1cooper/Three-axis-gimbal/README.md

# Three-axis gimbal

Status: In progress  
Sort: Prj

## TODO
- [x]  改进云台结构，4310电机承重2025-12-15 22:16:56
- [x]  等元器件，焊接2025-12-23 23:06:42
- [x]  改PCB sample LSB问题 dcdc啸叫2025-12-24 17:22:35
- [x]  等待PCB Ver1.12025-12-28 10:10:11
- [x]  焊接第二版
- [x]  开始打印结构件2026-01-03 15:18:30
- [x]  验证结构 2026-01-08 21:50:25
- [ ]  等Mech Ver1.2 2026-01-08 22:20:39

---

## Structure

### Ver1.0
<p align="center">
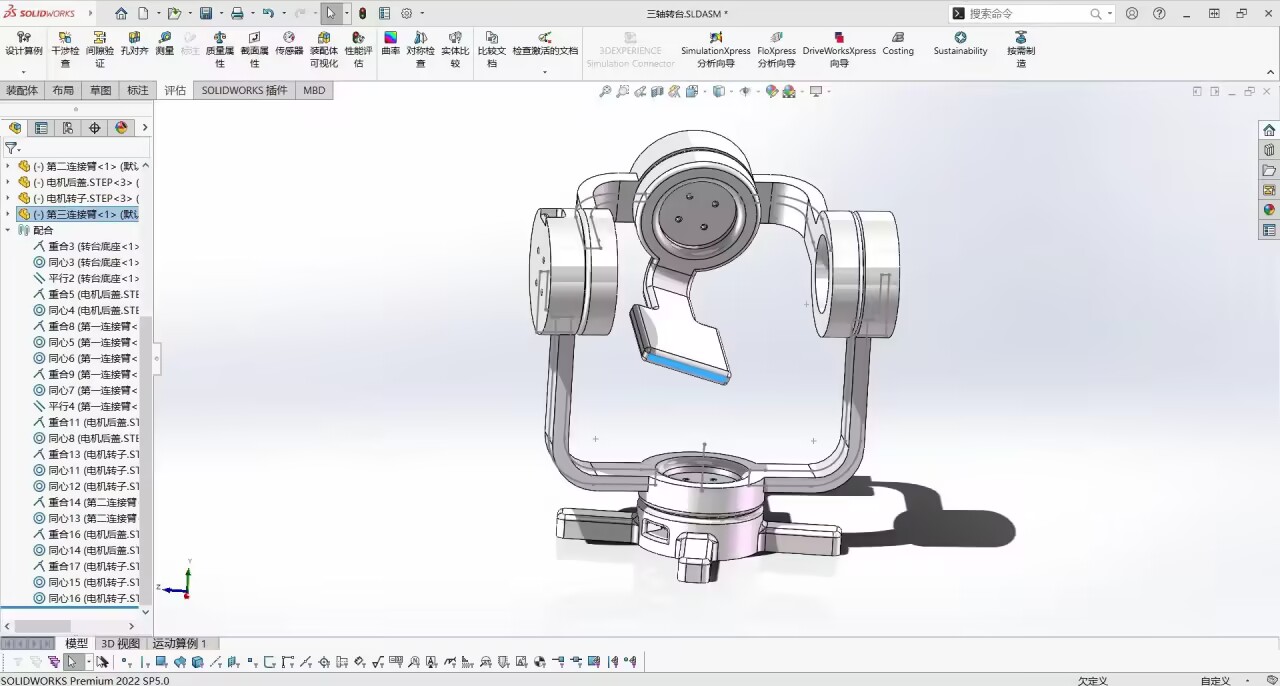
[picture p1: ExportBlock/9a7429444ead9815cb6c9cb01ef3c920_720.png]
  
</p>

### Ver1.1：底部加入支撑转盘
<p align="center">
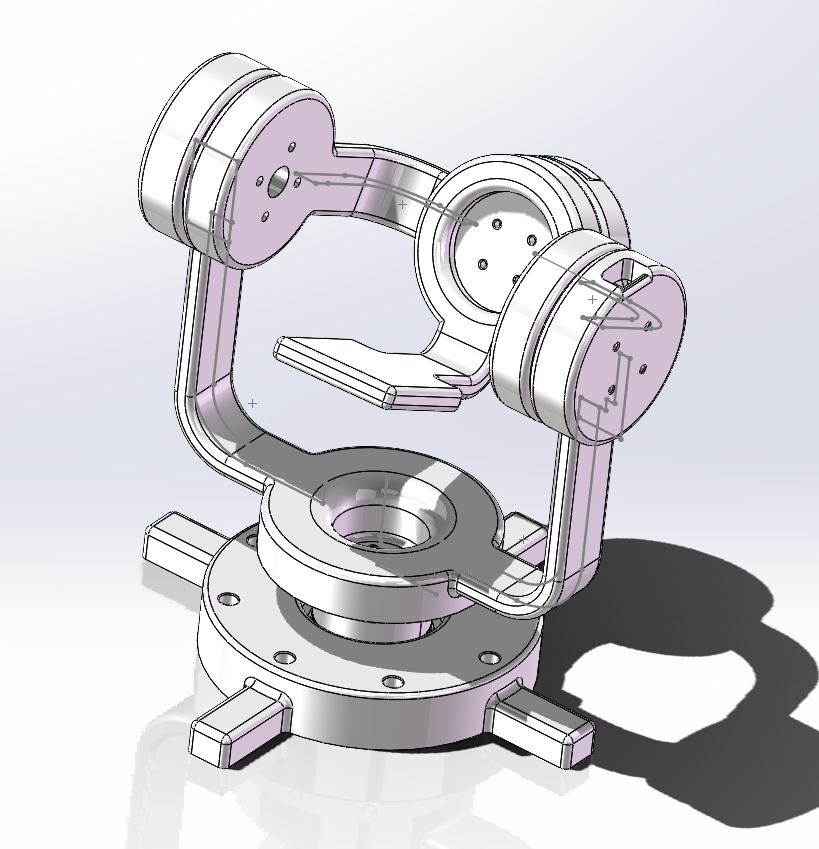
[picture p2: ExportBlock/image.png]
  
</p>

### Ver1.2：云台整体尺寸缩小
<p align="center">
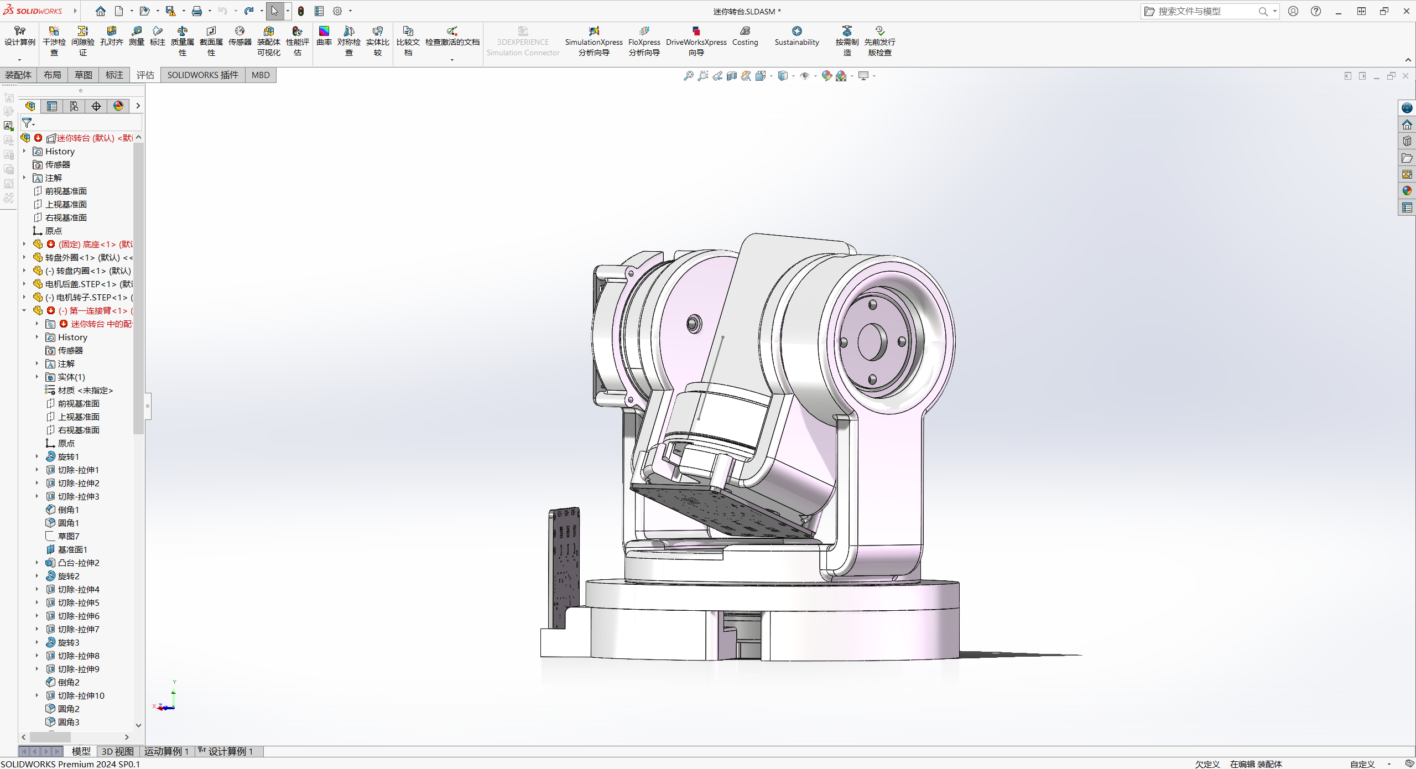
[picture p3: ExportBlock/image 1.png]
  
</p>

---

## Hardware

### Mini_Drv Ver1.0
<p align="center">
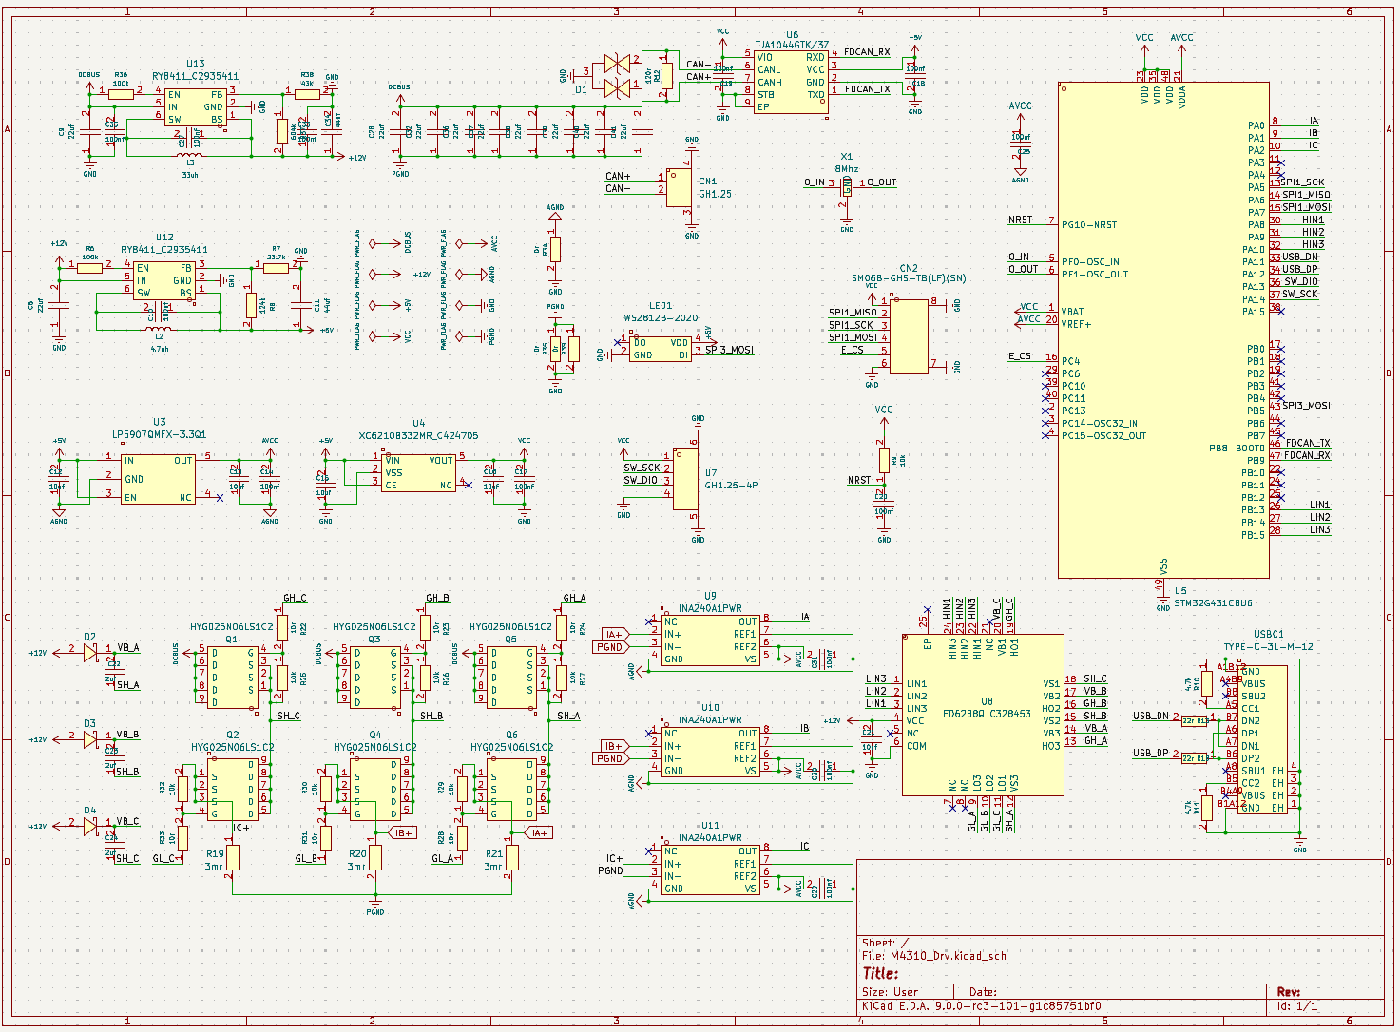
[picture p4: ExportBlock/image 2.png]
  <br>
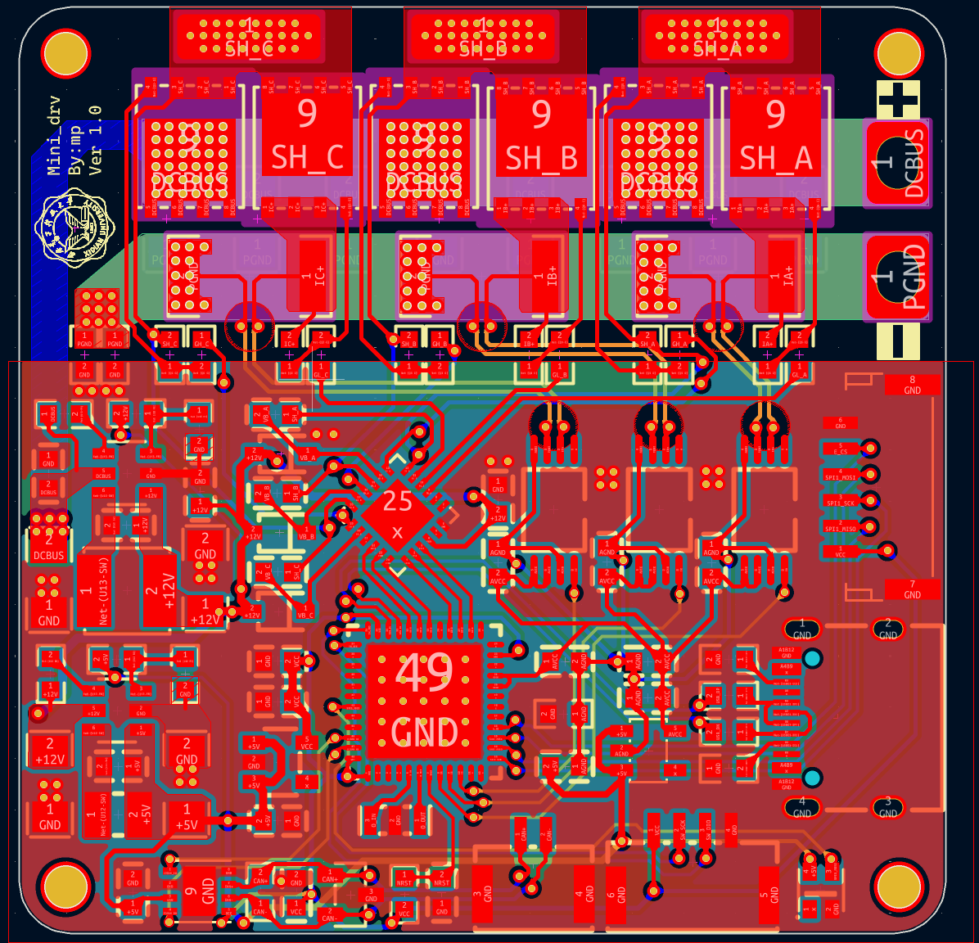
[picture p5: ExportBlock/image 3.png]
  <br>
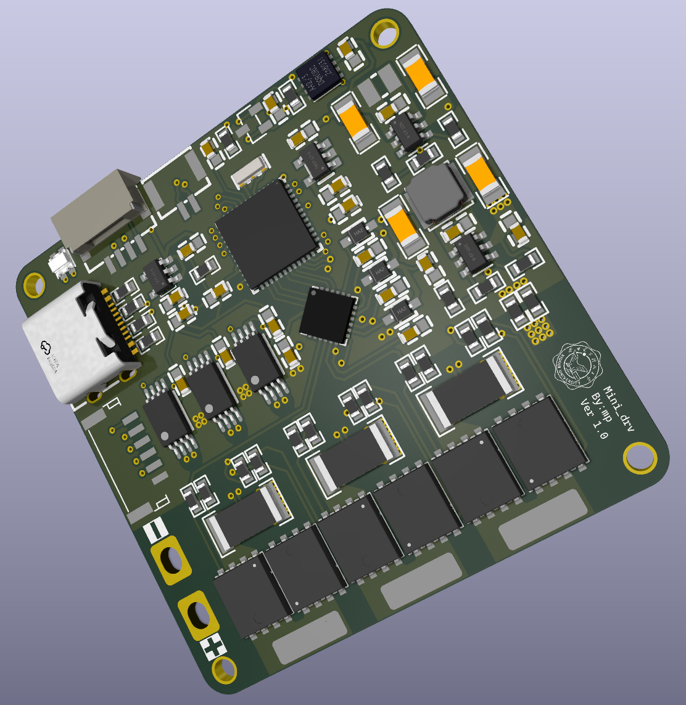
[picture p6: ExportBlock/image 4.png]
  
</p>

### Mini_Drv Ver1.1
<p align="center">
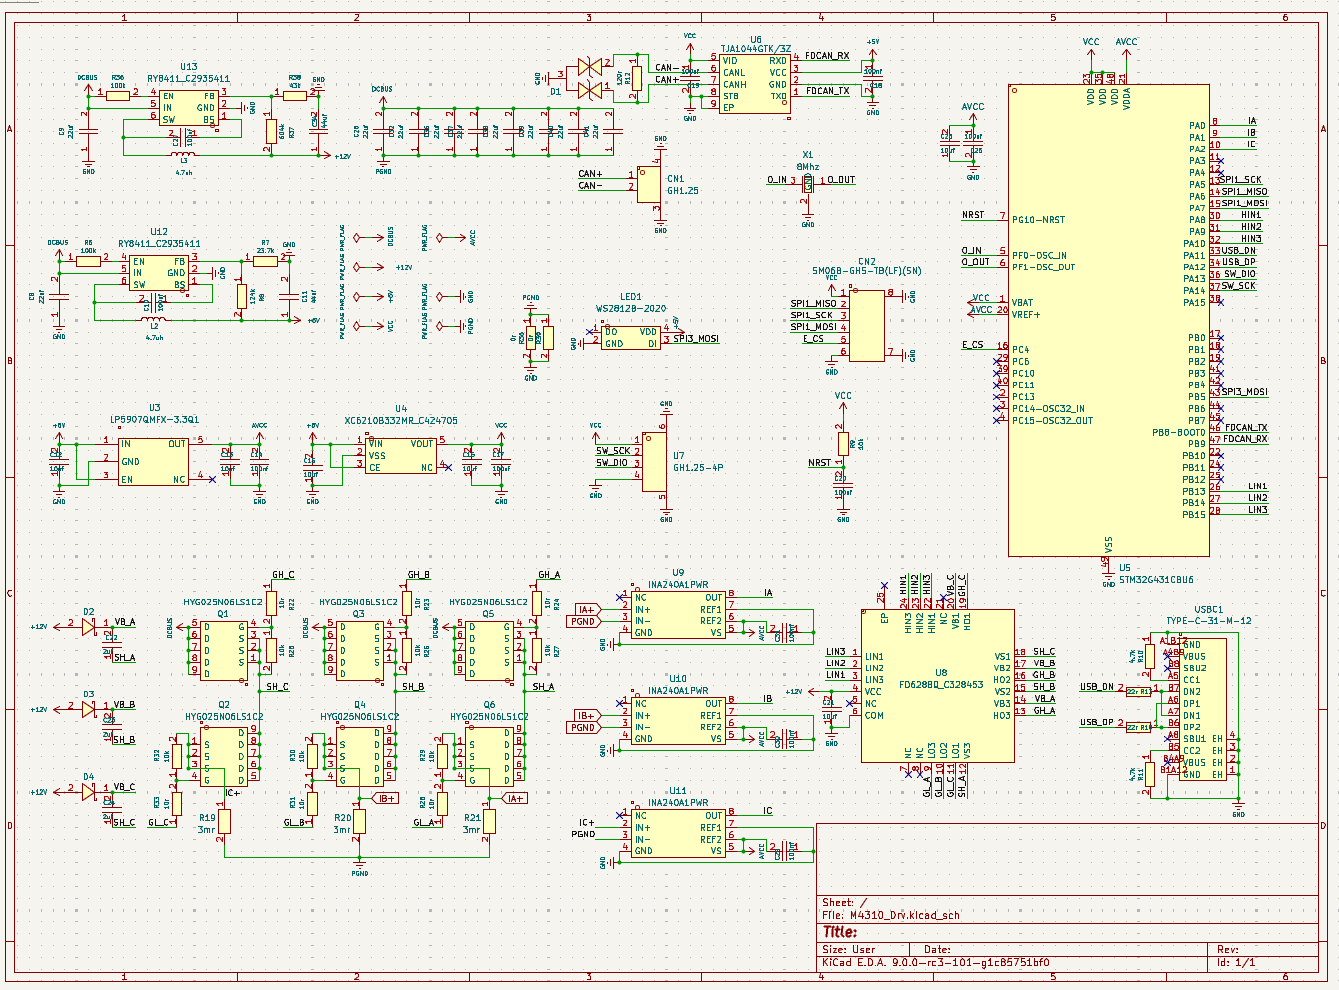
[picture p7: ExportBlock/image 5.png]
  <br>
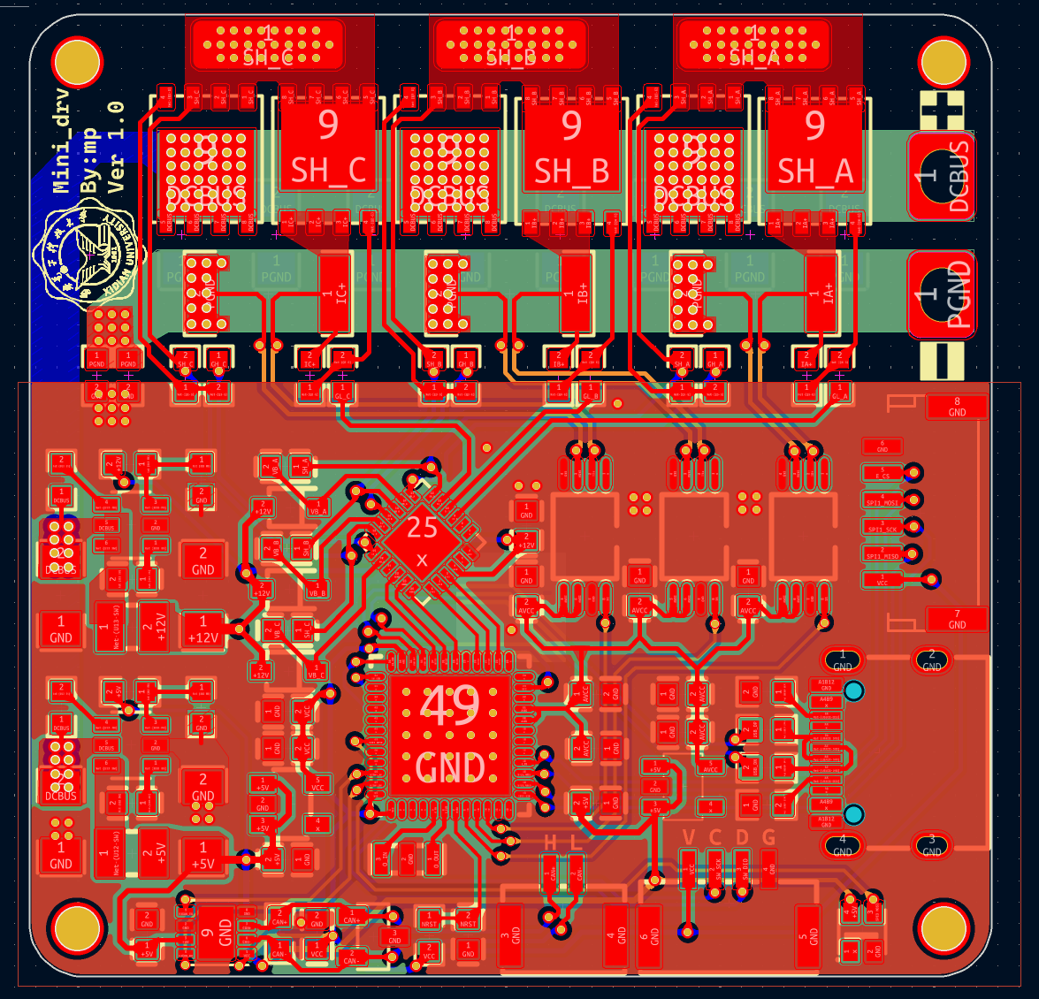
[picture p8: ExportBlock/image 6.png]
  <br>
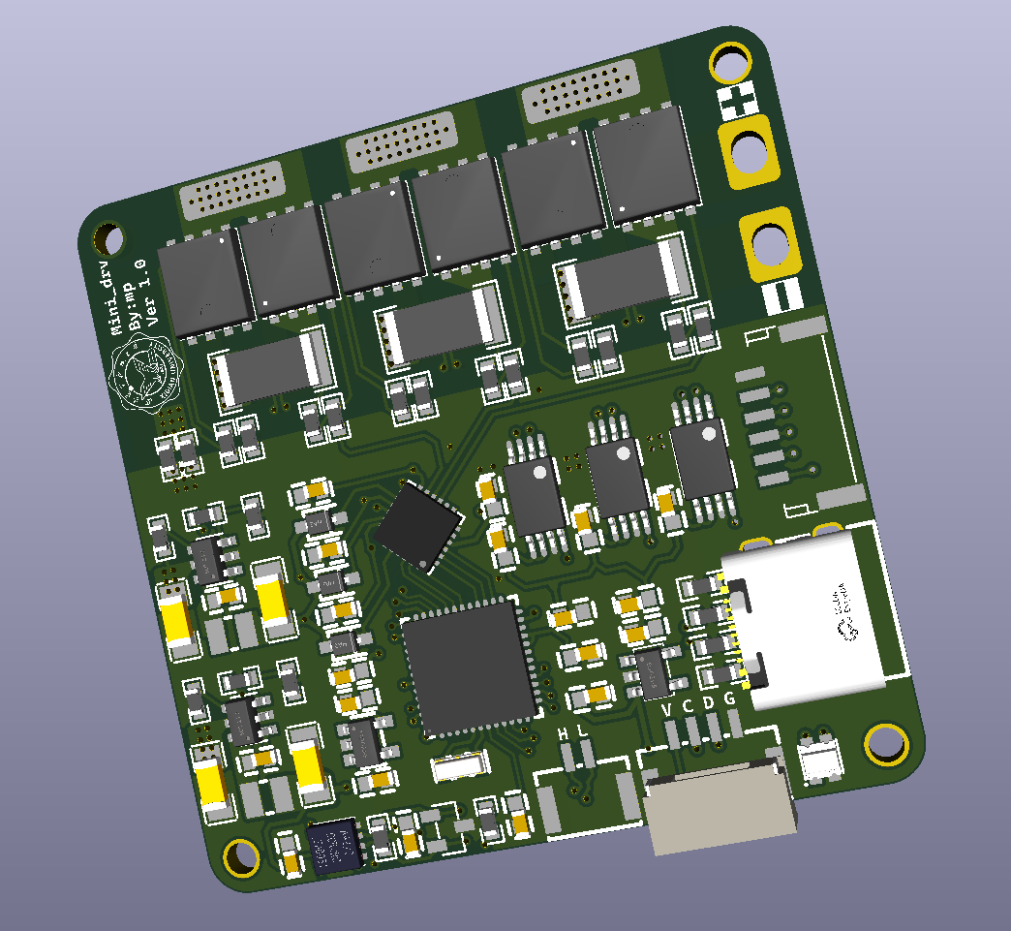
[picture p9: ExportBlock/image 7.png]
  
</p>

---

## Software

### pid参数
<p align="center">
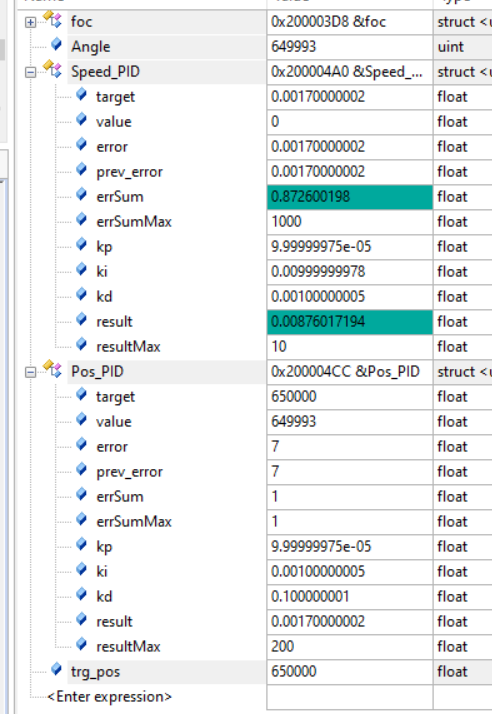
[picture p10: ExportBlock/image 8.png]
  
</p>

---

## Problems

### Hardware
- DCDC部分，错误地将芯片BS引脚与输出连在一起。
- MOS啸叫，未找到原因。纠正：MOS不会啸叫，压电类器件更易啸叫。

<p align="center">
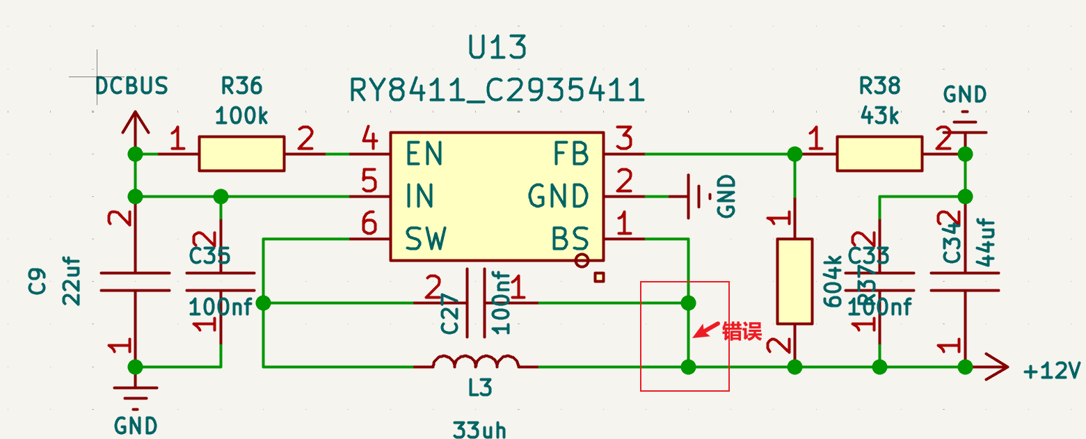
[picture p11: ExportBlock/Snipaste_2025-12-21_15-04-18.png]
  
</p>

### Mech
- 主体太大——下一版V1.2，建议10x10x10cm。
- PCB固定座偏小，不能完全嵌入，需留余量，可以竖直摆放。

<p align="center">
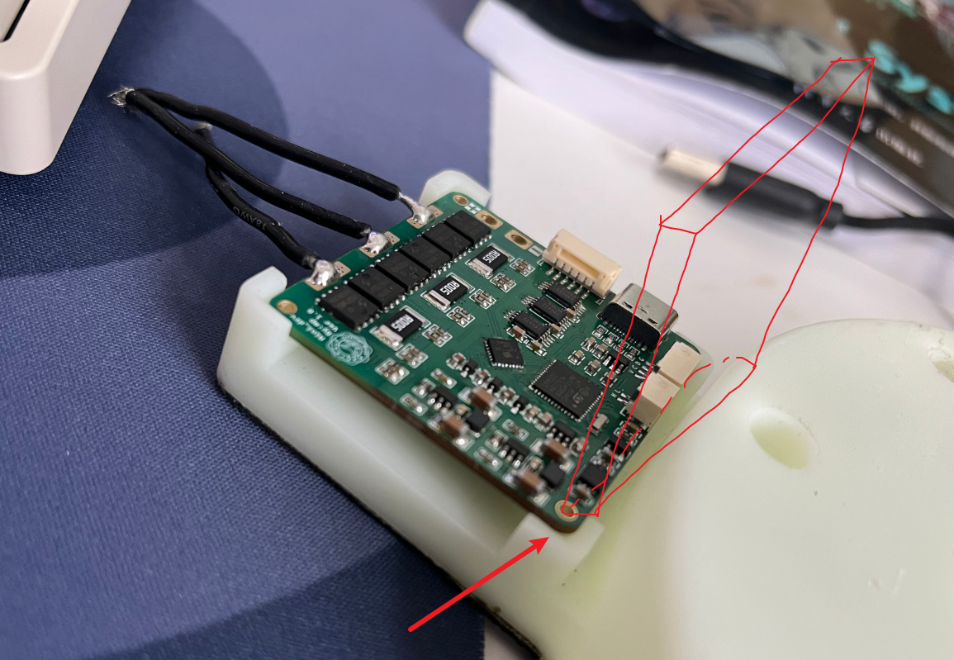
[picture p12: ExportBlock/image 9.png]
  
</p>
