1cooper/Three-axis-gimbal/Mech/三轴转台-双支撑/三轴转台.SLDASM

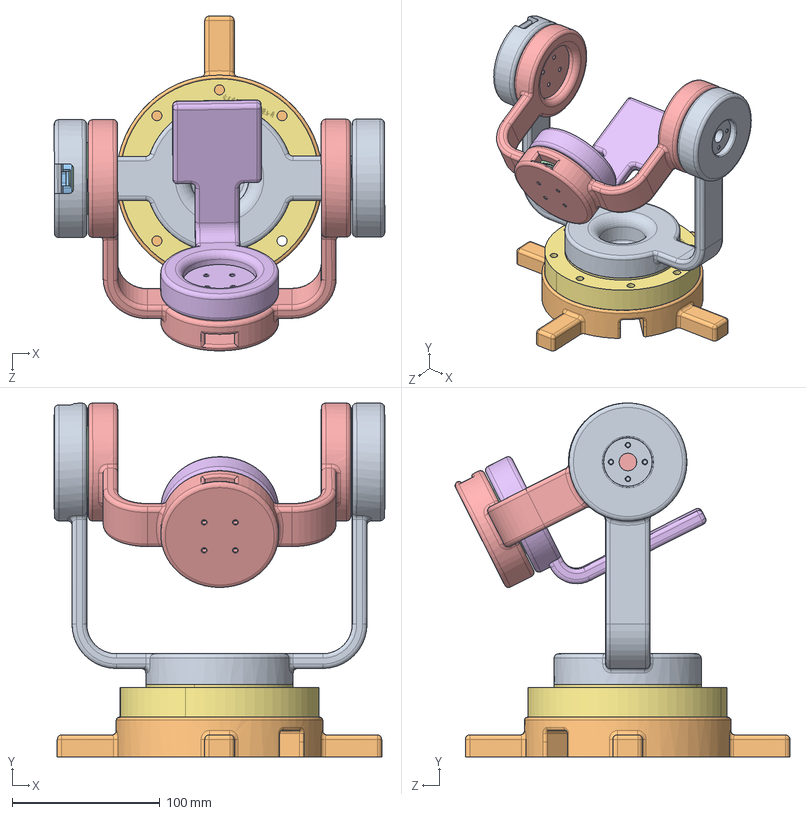
[picture p13: CAD file, 2026-01-08]
Mech/三轴转台-双支撑/三轴转台.SLDASM
224.1 x 240.0 x 227.0 mm
第一连接臂
转台底座
电机后盖.STEP x 3
电机转子.STEP x 3
第二连接臂
第三连接臂
3264716736010.10.100(1).step
