1cooper/Three-axis-gimbal/Hardware/M4310_Drv/edgecut.DXF

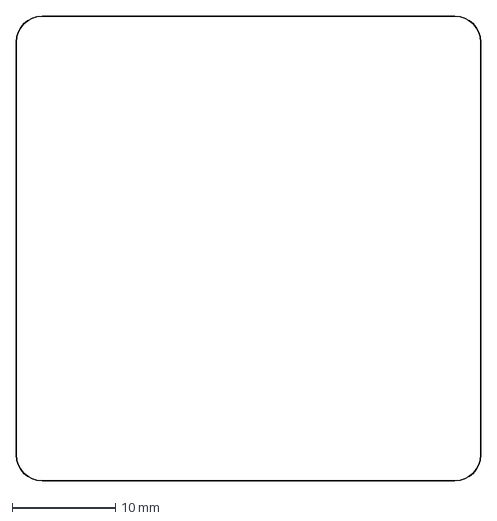
[picture p14: CAD file, 2025-12-28]
Hardware/M4310_Drv/edgecut.DXF
45.0 x 45.0 mm
