1cooper/Three-axis-gimbal/Mech/三轴转台-双支撑/第三连接臂.SLDPRT

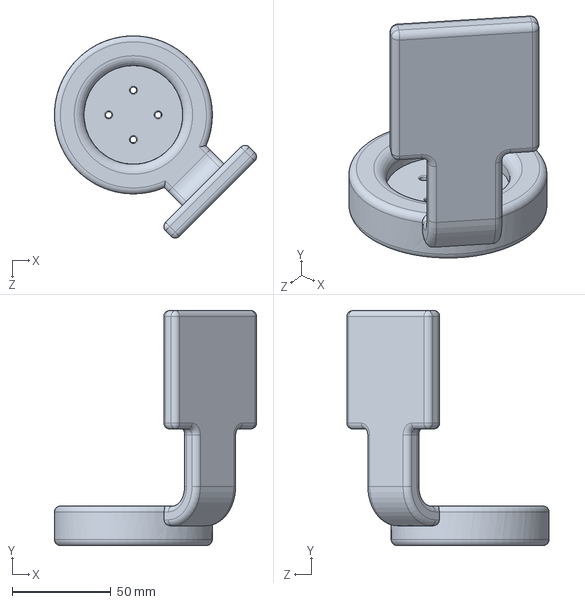
[picture p15: CAD file, 2026-01-08]
Mech/三轴转台-双支撑/第三连接臂.SLDPRT
102.4 x 119.0 x 102.4 mm
