1cooper/Three-axis-gimbal/Mech/板框中心线.DXF

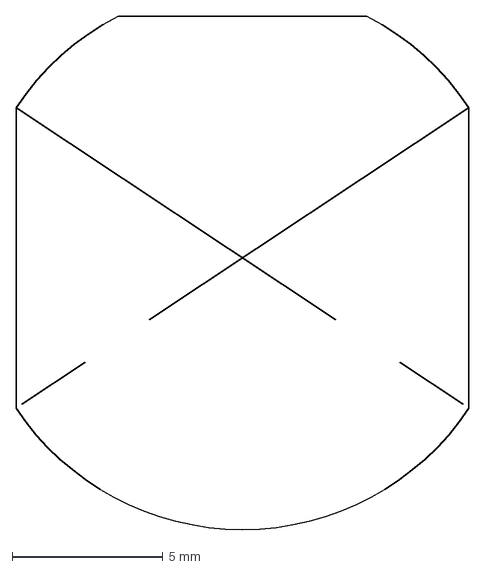
[picture p16: CAD file, 2025-12-28]
Mech/板框中心线.DXF
15.0 x 17.0 mm
