1cooper/Three-axis-gimbal/Mech/三轴转台-双支撑/第一连接臂.SLDPRT

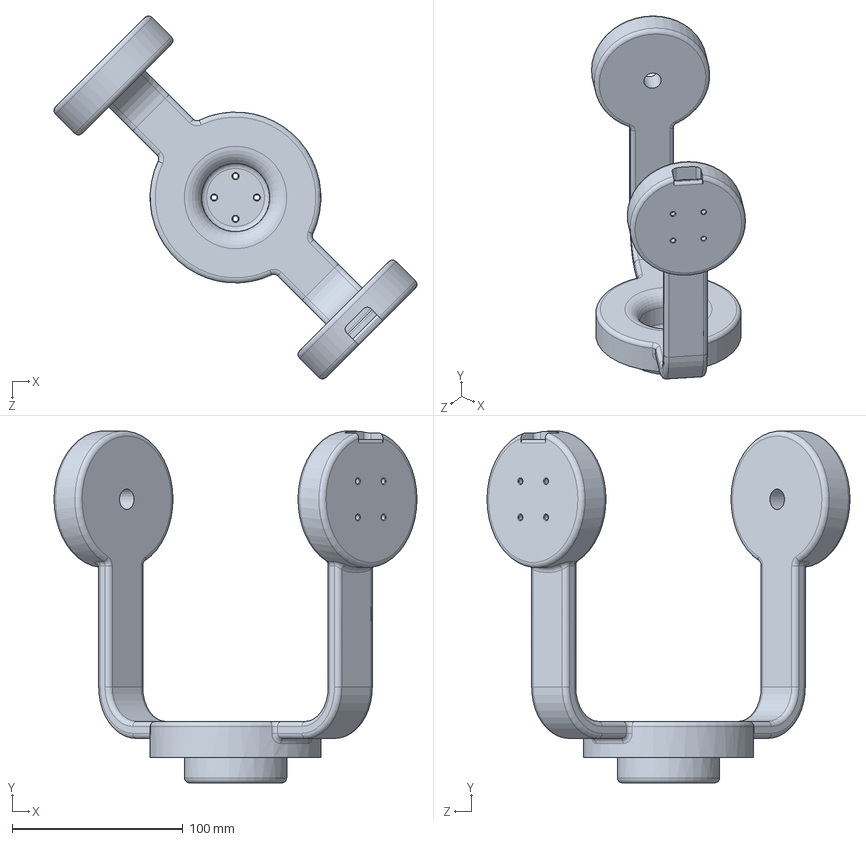
[picture p17: CAD file, 2026-01-08]
Mech/三轴转台-双支撑/第一连接臂.SLDPRT
212.5 x 205.9 x 212.5 mm
