1cooper/Three-axis-gimbal/Mech/三轴转台-双支撑/转台底座.SLDPRT

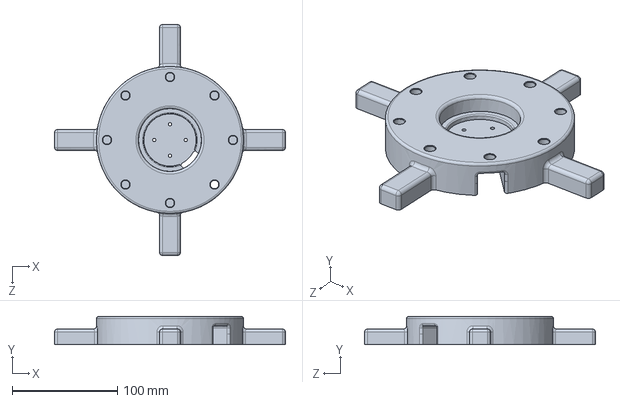
[picture p18: CAD file, 2026-01-08]
Mech/三轴转台-双支撑/转台底座.SLDPRT
220.0 x 27.0 x 220.0 mm
