1cooper/Three-axis-gimbal/Mech/三轴转台-双支撑/电机后盖.STEP.SLDPRT

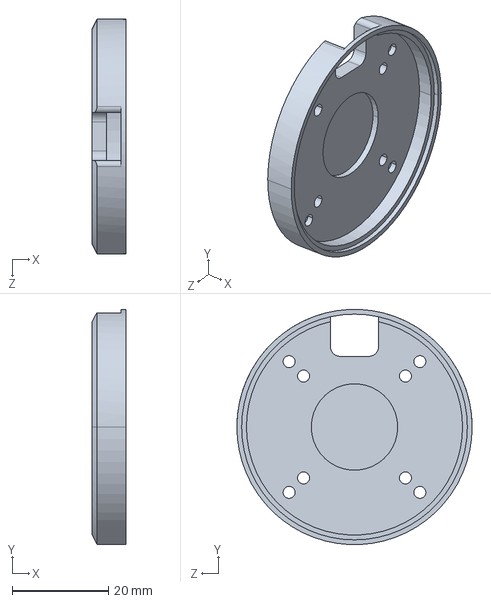
[picture p19: CAD file, 2026-01-08]
Mech/三轴转台-双支撑/电机后盖.STEP.SLDPRT
7.00 x 48.9 x 49.0 mm
