1cooper/Three-axis-gimbal/Mech/三轴转台-双支撑/第二连接臂.SLDPRT

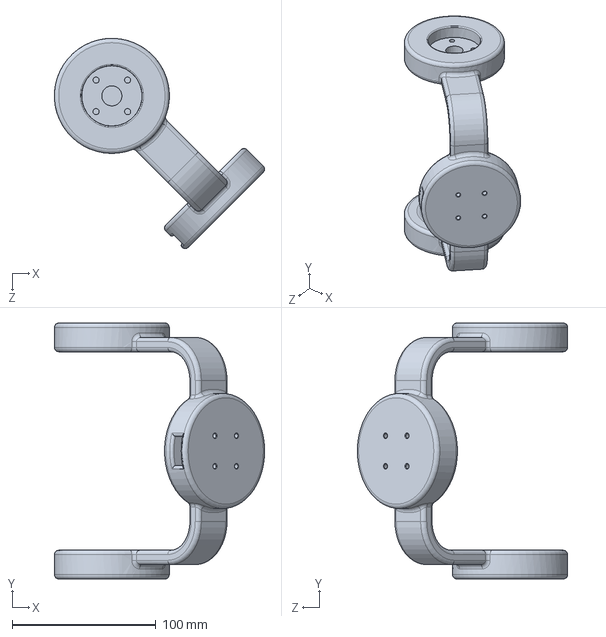
[picture p20: CAD file, 2026-01-08]
Mech/三轴转台-双支撑/第二连接臂.SLDPRT
146.2 x 178.0 x 146.2 mm
