1cooper/Three-axis-gimbal/Mech/三轴转台-双支撑/电机转子.STEP.SLDPRT

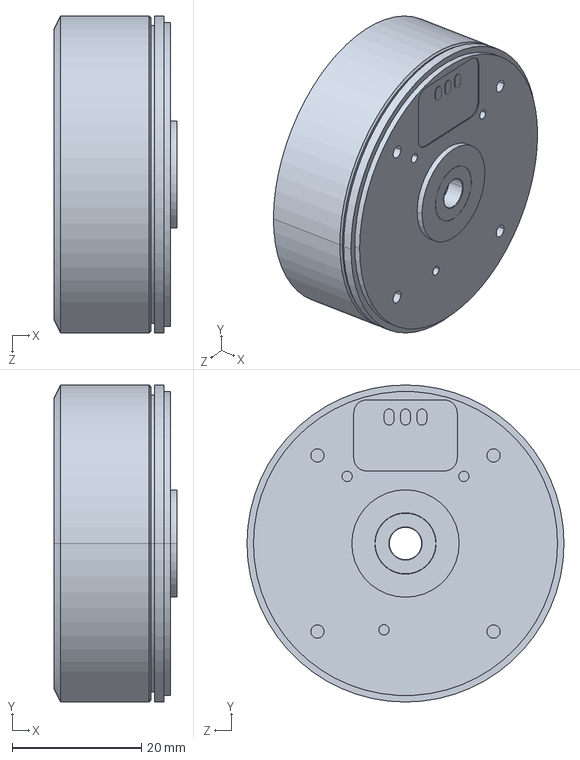
[picture p21: CAD file, 2026-01-08]
Mech/三轴转台-双支撑/电机转子.STEP.SLDPRT
19.0 x 49.0 x 49.0 mm
