1cooper/Three-axis-gimbal/Mech/三轴转台-双支撑/3264716736010.10.100(1).STEP

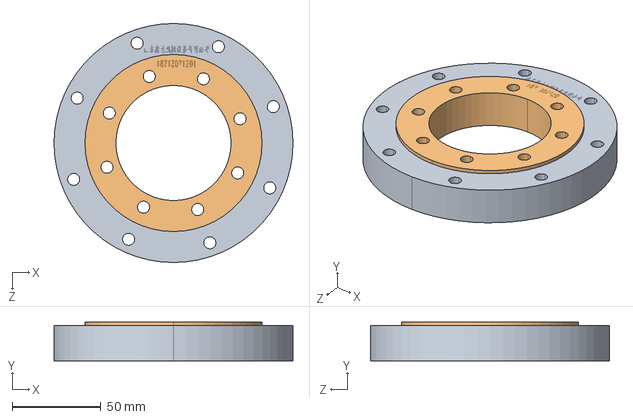
[picture p22: CAD file, 2026-01-08]
Mech/三轴转台-双支撑/3264716736010.10.100(1).STEP
135.0 x 22.0 x 135.0 mm
