1cooper/Three-axis-gimbal/(list of files, cad)

Other CAD files:
Mech/板框.SLDPRT
Mech/板框.DXF
