1cooper/Three-axis-gimbal/Hardware/M4310_Drv/M4310_Drv.kicad_sch

## KiCad design Hardware/M4310_Drv/M4310_Drv.kicad_sch (2025-12-28)

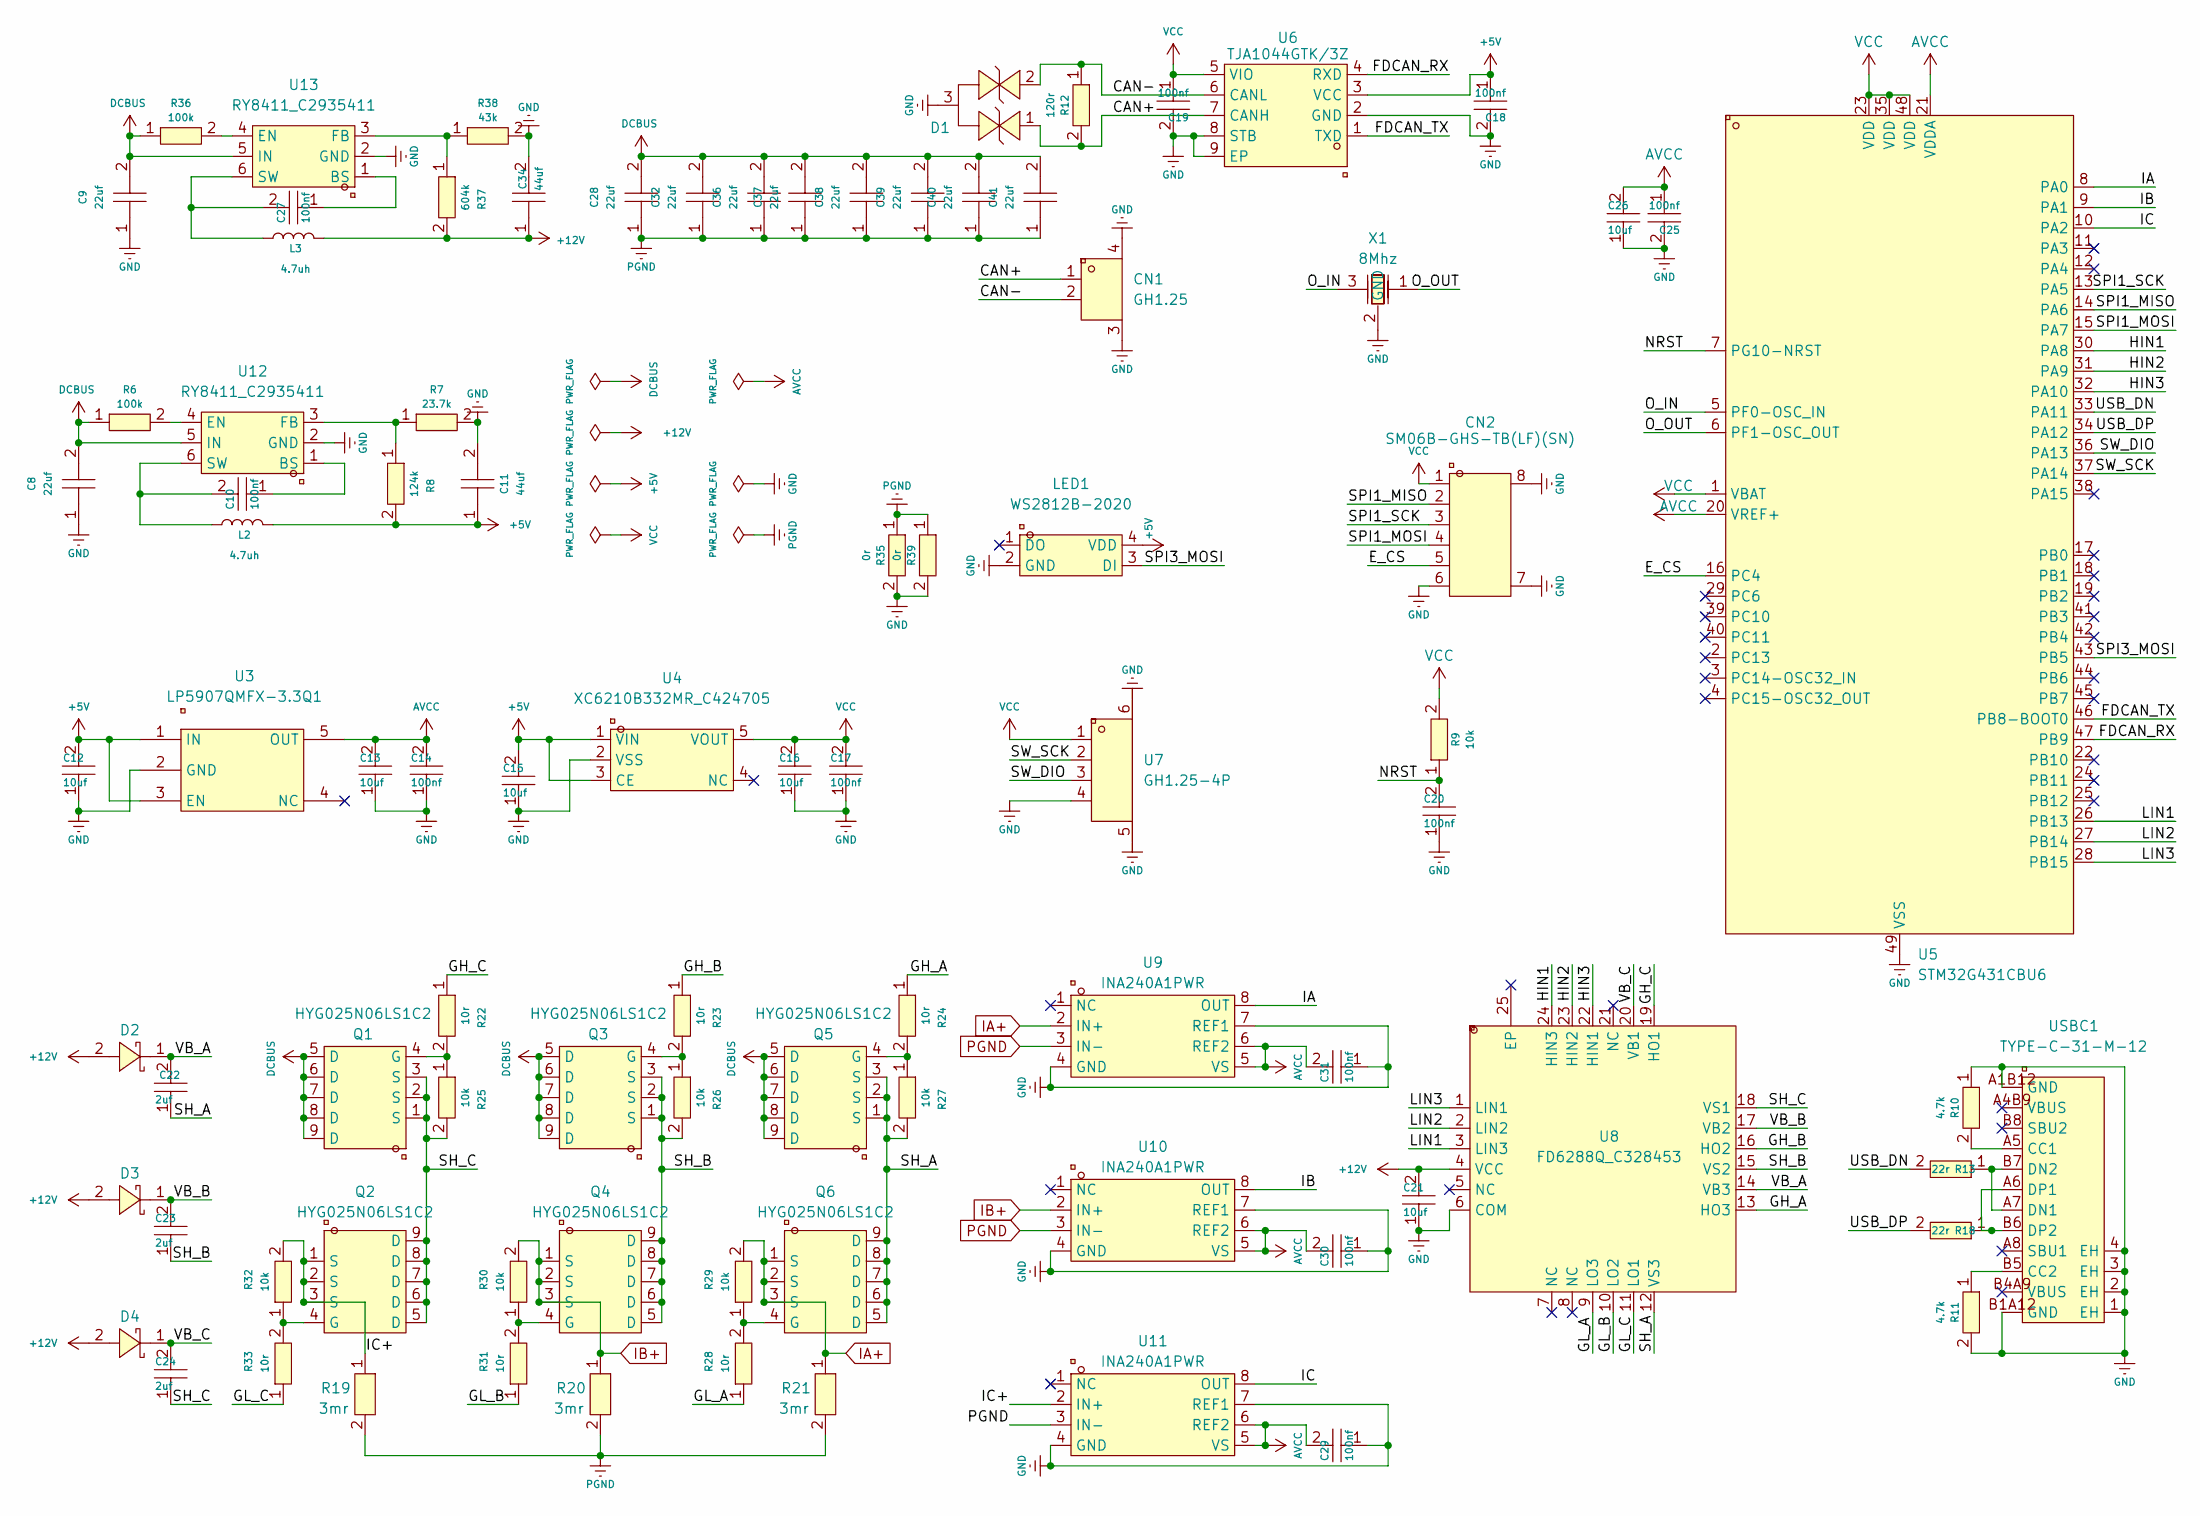
[picture p23: schematic M4310_Drv.kicad_sch]

Parts:
C8, C9, C28, C32, C36, C37, C38, C39, C40, C41: 22uf; C1206; LCSC Part C89632
C10, C14, C17, C18, C19, C20, C25, C27, C29, C30, C31: 100nf; C0603; LCSC Part C1604
C11, C34: 44uf; C1206; LCSC Part C89632
C12, C13, C15, C16, C21, C26: 10uf; C0603; LCSC Part C1604
C22, C23, C24: 2uf; C0603; LCSC Part C1604
CN1: GH1.25; CONN-TH_2P-P1.25_XUNPU_WAFER-GH1.25-2PWB; LCSC Part C3029377
CN2: SM06B-GHS-TB(LF)(SN); CONN-TH_SM06B-GHS-TB-LF-SN; LCSC Part C133065
D1: NUP2105LT1G_C2890118; SOT-23-3_L2.9-W1.3-P1.90-LS2.4-BR; LCSC Part C2890118
D2, D3, D4: 1N5819WS S4; SOD-323_L1.6-W1.3-LS2.7-RD; LCSC Part C2927280
L2, L3: 4.7uh; IND-SMD_L2.5-W2.0
LED1: WS2812B-2020; LED-SMD_4P-L2.0-W2.0-TL_WS2812B-2020; LCSC Part C965555
Q1, Q2, Q3, Q4, Q5, Q6: HYG025N06LS1C2; DFN-8_L5.9-W5.2-P1.27-LS6.2-BL; LCSC Part C2827231
R6, R36: 100k; R0603; LCSC Part C14675
R7: 23.7k; R0603; LCSC Part C14675
R8: 124k; R0603; LCSC Part C14675
R9, R25, R26, R27, R29, R30, R32: 10k; R0603; LCSC Part C14675
R10, R11: 4.7k; R0603; LCSC Part C14675
R12: 120r; R0603; LCSC Part C14675
R13, R18: 22r; R0603; LCSC Part C14675
R19, R20, R21: 3mr; R2512; LCSC Part C46634460
R22, R23, R24, R28, R31, R33: 10r; R0603; LCSC Part C14675
R35, R39: 0r; R0603; LCSC Part C14675
R37: 604k; R0603; LCSC Part C14675
R38: 43k; R0603; LCSC Part C14675
U3: LP5907QMFX-3.3Q1; SOT-23-5_L3.0-W1.7-P0.95-LS2.8-BR; LCSC Part C130005
U4: XC6210B332MR_C424705; TSOT-23-5_L2.9-W1.6-P0.95-LS2.8-BR; LCSC Part C424705
U5: STM32G431CBU6; VQFN-48_L7.0-W7.0-P0.50-BL-EP5.5; LCSC Part C529356
U6: TJA1044GTK/3Z; HVSON-8_L3.0-W3.0-P0.65-BL-EP; LCSC Part C2157795
U7: GH1.25-4P; CONN-SMD_4P-P1.25_XUNPU_WAFER-GH1.25-4PWB; LCSC Part C3029379
U8: FD6288Q_C328453; QFN-24_L4.0-W4.0-P0.50-BL-EP2.6; LCSC Part C328453
U9, U10, U11: INA240A1PWR; TSSOP-8_L4.4-W3.0-P0.65-LS6.4-BL; LCSC Part C93965
U12, U13: RY8411_C2935411; SOT-23-6_L2.9-W1.6-P0.95-LS2.8-TL; LCSC Part C2935411
USBC1: TYPE-C-31-M-12; USB-C_SMD-TYPE-C-31-M-12_1; LCSC Part C165948
X1: 8Mhz; OSC-SMD_3P-L3.2-W1.3-P1.20-L; LCSC Part C341525

Connections:
+5V: C11.1, C12.2, C15.2, C18.1, L2.2, LED1.4 (VDD), R8.2, U3.1 (IN), U3.3 (EN), U4.1 (VIN), U4.3 (CE), U6.3 (VCC)
+12V: C21.2, C34.1, D2.2, D3.2, D4.2, L3.2, R37.2, U8.4 (VCC)
AVCC: C13.2, C14.2, C25.1, C26.2, C29.2, C30.2, C31.2, U3.5 (OUT), U5.20 (VREF+), U5.21 (VDDA), U9.5 (VS), U9.6 (REF2), U10.5 (VS), U10.6 (REF2), U11.5 (VS), U11.6 (REF2)
CAN+: CN1.1, D1.1, R12.2, U6.7 (CANH)
CAN-: CN1.2, D1.2, R12.1, U6.6 (CANL)
DCBUS: C8.2, C9.2, C28.2, C32.2, C36.2, C37.2, C38.2, C39.2, C40.2, C41.2, Q1.5 (D), Q1.6 (D), Q1.7 (D), Q1.8 (D), Q1.9 (D), Q3.5 (D), Q3.6 (D), Q3.7 (D), Q3.8 (D), Q3.9 (D), Q5.5 (D), Q5.6 (D), Q5.7 (D), Q5.8 (D), Q5.9 (D), R6.1, R36.1, U12.5 (IN), U13.5 (IN)
E_CS: CN2.5, U5.16 (PC4)
FDCAN_RX: U5.47 (PB9), U6.4 (RXD)
FDCAN_TX: U5.46 (PB8-BOOT0), U6.1 (TXD)
GH_A: R24.1, U8.13 (HO3)
GH_B: R23.1, U8.16 (HO2)
GH_C: R22.1, U8.19 (HO1)
GL_A: R28.1, U8.9 (LO3)
GL_B: R31.1, U8.10 (LO2)
GL_C: R33.1, U8.11 (LO1)
GND: C8.1, C9.1, C11.2, C12.1, C13.1, C14.1, C15.1, C16.1, C17.1, C18.2, C19.2, C20.1, C21.1, C25.2, C26.1, C29.1, C30.1, C31.1, C34.2, CN1.3, CN1.4, CN2.6, CN2.7, CN2.8, D1.3, LED1.2 (GND), R7.2, R10.1, R11.2, R35.2, R38.2, R39.2, U3.2 (GND), U4.2 (VSS), U5.49 (VSS), U6.2 (GND), U6.8 (STB), U6.9 (EP), U7.4, U7.5, U7.6, U8.6 (COM), U9.4 (GND), U9.7 (REF1), U10.4 (GND), U10.7 (REF1), U11.4 (GND), U11.7 (REF1), U12.2 (GND), U13.2 (GND), USBC1.1 (EH), USBC1.2 (EH), USBC1.3 (EH), USBC1.4 (EH), USBC1.A1B12 (GND), USBC1.B1A12 (GND), X1.2 (GND)
HIN1: U5.30 (PA8), U8.24 (HIN3)
HIN2: U5.31 (PA9), U8.23 (HIN2)
HIN3: U5.32 (PA10), U8.22 (HIN1)
IA: U5.8 (PA0), U9.8 (OUT)
IA+: Q6.1 (S), Q6.2 (S), Q6.3 (S), R21.1, R29.2, U9.2 (IN+)
IB: U5.9 (PA1), U10.8 (OUT)
IB+: Q4.1 (S), Q4.2 (S), Q4.3 (S), R20.1, R30.2, U10.2 (IN+)
IC: U5.10 (PA2), U11.8 (OUT)
IC+: Q2.1 (S), Q2.2 (S), Q2.3 (S), R19.1, R32.2, U11.2 (IN+)
LIN1: U5.26 (PB13), U8.3 (LIN3)
LIN2: U5.27 (PB14), U8.2 (LIN2)
LIN3: U5.28 (PB15), U8.1 (LIN1)
NRST: C20.2, R9.1, U5.7 (PG10-NRST)
unnamed: C10.1, U12.1 (BS)
unnamed: C10.2, L2.1, U12.6 (SW)
unnamed: C27.1, U13.1 (BS)
unnamed: C27.2, L3.1, U13.6 (SW)
unnamed: Q1.4 (G), R22.2, R25.1
unnamed: Q2.4 (G), R32.1, R33.2
unnamed: Q3.4 (G), R23.2, R26.1
unnamed: Q4.4 (G), R30.1, R31.2
unnamed: Q5.4 (G), R24.2, R27.1
unnamed: Q6.4 (G), R28.2, R29.1
unnamed: R6.2, U12.4 (EN)
unnamed: R7.1, R8.1, U12.3 (FB)
unnamed: R10.2, USBC1.A5 (CC1)
unnamed: R11.1, USBC1.B5 (CC2)
unnamed: R13.1, USBC1.A7 (DN1), USBC1.B7 (DN2)
unnamed: R18.1, USBC1.A6 (DP1), USBC1.B6 (DP2)
unnamed: R36.2, U13.4 (EN)
unnamed: R37.1, R38.1, U13.3 (FB)
O_IN: U5.5 (PF0-OSC_IN), X1.3
O_OUT: U5.6 (PF1-OSC_OUT), X1.1
PGND: C28.1, C32.1, C36.1, C37.1, C38.1, C39.1, C40.1, C41.1, R19.2, R20.2, R21.2, R35.1, R39.1, U9.3 (IN-), U10.3 (IN-), U11.3 (IN-)
SH_A: C22.1, Q5.1 (S), Q5.2 (S), Q5.3 (S), Q6.5 (D), Q6.6 (D), Q6.7 (D), Q6.8 (D), Q6.9 (D), R27.2, U8.12 (VS3)
SH_B: C23.1, Q3.1 (S), Q3.2 (S), Q3.3 (S), Q4.5 (D), Q4.6 (D), Q4.7 (D), Q4.8 (D), Q4.9 (D), R26.2, U8.15 (VS2)
SH_C: C24.1, Q1.1 (S), Q1.2 (S), Q1.3 (S), Q2.5 (D), Q2.6 (D), Q2.7 (D), Q2.8 (D), Q2.9 (D), R25.2, U8.18 (VS1)
SPI1_MISO: CN2.2, U5.14 (PA6)
SPI1_MOSI: CN2.4, U5.15 (PA7)
SPI1_SCK: CN2.3, U5.13 (PA5)
SPI3_MOSI: LED1.3 (DI), U5.43 (PB5)
SW_DIO: U5.36 (PA13), U7.3
SW_SCK: U5.37 (PA14), U7.2
USB_DN: R13.2, U5.33 (PA11)
USB_DP: R18.2, U5.34 (PA12)
VB_A: C22.2, D2.1, U8.14 (VB3)
VB_B: C23.2, D3.1, U8.17 (VB2)
VB_C: C24.2, D4.1, U8.20 (VB1)
VCC: C16.2, C17.2, C19.1, CN2.1, R9.2, U4.5 (VOUT), U5.1 (VBAT), U5.23 (VDD), U5.35 (VDD), U5.48 (VDD), U6.5 (VIO), U7.1
