1cooper/Three-axis-gimbal/Software/Mini_Drv/Mini_Drv.ioc

Mcu.UserName=STM32G431CBUx
PA0.Signal=ADC1_IN1
PA1.Signal=ADC1_IN2
PA10.Signal=S_TIM1_CH3
PA11.Signal=USB_DM
PA12.Signal=USB_DP
PA13.Signal=SYS_JTMS-SWDIO
PA14.Signal=SYS_JTCK-SWCLK
PA2.Signal=ADC1_IN3
PA5.Signal=SPI1_SCK
PA6.Signal=SPI1_MISO
PA7.Signal=SPI1_MOSI
PA8.Signal=S_TIM1_CH1
PA9.Signal=S_TIM1_CH2
PB13.Signal=TIM1_CH1N
PB14.Signal=TIM1_CH2N
PB15.Signal=TIM1_CH3N
PB5.Signal=SPI3_MOSI
PB8-BOOT0.Signal=FDCAN1_RX
PB9.Signal=FDCAN1_TX
PC10.Signal=SPI3_SCK
PC4.GPIO_Label=ENCODER_CS
PC4.Signal=GPIO_Output
PF0-OSC_IN.Signal=RCC_OSC_IN
PF1-OSC_OUT.Signal=RCC_OSC_OUT
