1cooper/Three-axis-gimbal/Software/Mini_Drv/Core/Src/main.c

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
/* Includes ------------------------------------------------------------------*/
#include "main.h"
#include "adc.h"
#include "fdcan.h"
#include "gpio.h"
#include "spi.h"
#include "tim.h"
#include "usb_device.h"

/* USER CODE BEGIN Includes */
#include "foc.h"
#include "pid.h"
#include "task_cfg.h"
#include "usbd_cdc_if.h"
#include "ws2812.h"
/* USER CODE END Includes */


void SystemClock_Config(void);
/**
 * @brief  The application entry point.
 * @retval int
 */
int main(void)
{
  /* MCU Configuration--------------------------------------------------------*/

  /* Reset of all peripherals, Initializes the Flash interface and the Systick. */
  HAL_Init();

  /* Configure the system clock */
  SystemClock_Config();

  /* Initialize all configured peripherals */
  MX_GPIO_Init();
  MX_ADC1_Init();
  MX_TIM1_Init();
  MX_FDCAN1_Init();
  MX_SPI1_Init();
  MX_SPI3_Init();
  MX_USB_Device_Init();
  MX_TIM2_Init();
  /* USER CODE BEGIN 2 */
  Task_Init();
  /* USER CODE END 2 */

  /* Infinite loop */
  /* USER CODE BEGIN WHILE */
  while(1)
  {
    /* USER CODE END WHILE */

    /* USER CODE BEGIN 3 */
    //		usbvcom_printf("%f,%f,%f\n", foc.i_a, foc.i_b, foc.i_c);
    //		WS2812_BreathEffect_Smooth(&ws2812);
    //		HAL_Delay(1);
    usbvcom_printf("%f,%f\n", foc.pulse, Speed_PID.result);
  }
  /* USER CODE END 3 */
}

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
