1cooper/Three-axis-gimbal/Software/Mini_Drv/User/maintask.h

#ifndef __MAINTASK_H__
#define __MAINTASK_H__

/* Private includes ----------------------------------------------------------*/
/* Private define ------------------------------------------------------------*/
/* Private typedef -----------------------------------------------------------*/
/* Private extern variables --------------------------------------------------*/
/* Private function declaration ----------------------------------------------*/

#endif
