1cooper/Three-axis-gimbal/(notices)

Notices in the files:
Software/Mini_Drv/Core/Src/main.c:
Copyright (c) 2025 STMicroelectronics.
All rights reserved.
This software is licensed under terms that can be found in the LICENSE file
